inspireFly-VT/inspireFly-FlightController/inspireFly-flightController/bom/FlightController_BOM.xlsx

Sheet: Config
inspireFly Flight Controller BOM
Inputs
Boards to Build | 3 | Number of Flight Controller boards being manufactured
Spare / Attrition % | 10.0% | Extra % added to passives (C_/R_) before rounding up. Leave 0% for net quantity + rounding only.
Passive Round-Up Multiple | 5 | Footprints starting with C_ or R_ round up to the next multiple of this. Other parts are not rounded.
Summary
Unique Line Items | 32
Parts per Board | 76
Total Net Parts | 271
Lines with Part Number | 25
Lines Missing Part Number | 7
Lines with Distributor Part Number | 25
Lines Missing Distributor Part Number | 7
Lines Missing from Order Sheets | 0
Legend
Blue text | Hardcoded input / manual entry
Yellow fill | Cells you should fill in (board count, sourcing for parts not yet found)
Black text | Formula - do not overwrite
Green text | Formula linking to another sheet
Qty per Board is counted from the References column, so adding/removing a designator updates every total. Digikey sheet column A pulls the Distributor Part Number from the BOM. Source data: inspireFly-flightController.csv (KiCad BOM export); sourcing for matching parts carried over from RemotePCB_BOM.xlsx.

Sheet: BOM
Item | References | Value | Footprint | Qty per Board | Total Qty | Distributor | Part Number | Distributor Part Number | Part Description | Order Sheet Check
1 | C3, C4, C5, C6, C8, C9, C10, C12, C15, C16, C22, C26, C32, C33, C35 | 100nF | C_0402_1005Metric_Pad0.74x0.62mm_HandSolder | 15 | 50 | Digikey | GRM155R71H104KE14D | 490-10700-1-ND | CAP CER 0.1UF 50V X7R 0402 | Found
2 | C7, C11, C23, C24, C25, C27, C28 | 1uF | C_0402_1005Metric_Pad0.74x0.62mm_HandSolder | 7 | 25 | Digikey | KAM05CR71A105KH | 478-KAM05CR71A105KHCT-ND | 0402 X7R 1UF10% 10V AEC-Q200 | Found
3 | C13, C14 | 22pF | C_0402_1005Metric_Pad0.74x0.62mm_HandSolder | 2 | 10 | Digikey | CC0402JRNPO9BN220 | 311-1018-1-ND | CAP CER 22PF 50V C0G/NPO 0402 | Found
4 | C17, C18 | 18pF | C_0402_1005Metric_Pad0.74x0.62mm_HandSolder | 2 | 10 | Digikey | CC0402JRNPO9BN180 | 311-1415-1-ND | CAP CER 18PF 50V C0G/NPO 0402 | Found
5 | C19, C29 | 10nF | C_0402_1005Metric_Pad0.74x0.62mm_HandSolder | 2 | 10 | Digikey | CC0402KRX7R9BB103 | 311-1349-1-ND | CAP CER 10000PF 50V X7R 0402 | Found
6 | C20, C30 | 1.5F | SUPERCAP_KR-5R5H155-R | 2 | 6 | Digikey | KR-5R5H155-R | 283-KR-5R5H155-R-ND | CAP 1.5F -20% +80% 5.5V T/H | Found
7 | C1 | 4.7uF | C_0603_1608Metric | 1 | 5 | Digikey | GMC10X7R475K10NT | 4713-GMC10X7R475K10NTCT-ND | CAP0603 X7R 4.7UF 10% 10V | Found
8 | C2 | 10uF | C_0603_1608Metric | 1 | 5 | Digikey | GMC10X7R106K10NT | 4713-GMC10X7R106K10NTCT-ND | CAP0603 X7R 10UF 10% 10V | Found
9 | C31 | 2.2nF | C_0402_1005Metric_Pad0.74x0.62mm_HandSolder | 1 | 5 | Digikey | CC0402KRX7R9BB222 | 311-1037-1-ND | CAP CER 2200PF 50V X7R 0402 | Found
10 | C34 | 22nF | C_0402_1005Metric_Pad0.74x0.62mm_HandSolder | 1 | 5 | Digikey | CC0402KRX7R9BB223 | 311-1722-1-ND | CAP CER 0.022UF 50V X7R 0402 | Found
11 | R1, R3, R4, R5, R10, R13, R14, R15, R18, R20, R37, R38, R40 | 10K | R_0402_1005Metric_Pad0.72x0.64mm_HandSolder | 13 | 45 | Digikey | ERA-2AEB103X | P10KDCCT-ND | RES SMD 10K OHM 0.1% 1/16W 0402 | Found
12 | R6, R16, R17, R19, R39 | 4.7k | R_0402_1005Metric_Pad0.72x0.64mm_HandSolder | 5 | 20 | Digikey | RT0402BRD074K7L | YAG1446CT-ND | RES SMD 4.7K OHM 0.1% 1/16W 0402 | Found
13 | R8, R11, R12 | 100k | R_0402_1005Metric_Pad0.72x0.64mm_HandSolder | 3 | 10 | Digikey | RT0402BRE07100KL | YAG2304CT-ND | RES SMD 100K OHM 0.1% 1/16W 0402 | Found
14 | R9 | 150k | R_0402_1005Metric_Pad0.72x0.64mm_HandSolder | 1 | 5 | Digikey | RT0402BRD07150KL | 13-RT0402BRD07150KLCT-ND | RES 150K OHM 0.1% 1/16W 0402 | Found
15 | U3, U6 | RV-8803-C7 | RTC_RV-8803-C7 | 2 | 6 | Digikey | RV-8803-C7-32.768KHZ-3PPM-TA-QA | 2195-RV-8803-C7-32.768KHZ-3PPM-TA-QACT-ND | IC RTC CLK/CALENDAR I2C 8SON | Found
16 | U1 | STM32U595VJT6 | LQFP-100_14x14mm_P0.5mm | 1 | 3 | STM | STM32U595VIT6 | STM32U595VIT6 | Ultra-low-power with FPU Arm Cortex-M33 MCU with TrustZone, 160 MHz with 2 Mbytes of Flash memory | Found
17 | U2 | BNO086 | BNO086 | 1 | 3 | Digikey | BNO086 | 1888-BNO086CT-ND | ACCELROMETER/GYRO SMD | Found
18 | U4 | LM66100DCK | SOT-363_SC-70-6 | 1 | 3 | Digikey | LM66100DCKR | 296-53541-1-ND | IC OR CTRLR IDEAL DIODE SC70-6 | Found
19 | U5 | TPS2117 | PWRMUX_TPS2117-DRL | 1 | 3 | Digikey | TPS2117DRLR | 296-TPS2117DRLRCT-ND | IC POWER SW SOT-583 | Found
20 | U7 | MX60LF8G28AD-TI | TSOPI48_MAC | 1 | 3 | Digikey | MX60LF8G28AD-TI | 1092-MX60LF8G28AD-TI-ND | IC FLASH 8GBIT PARALLEL 48TSOP | Found
21 | U8 | S-19400G28A-K8T2U4 | TMSOP-8 | 1 | 3 | Digikey | S-19400G28A-K8T2U4 | 1662-S-19400G28A-K8T2U4CT-ND | WATCHDOG TIMER | Found
22 | Y1 | ABS07-32.768KHZ-T | XTAL_ABS07-32.768KHZ-T | 1 | 3 | Digikey | ABS07-32.768KHZ-T | 535-9542-1-ND | CRYSTAL 32.7680KHZ 12.5PF SMD | Found
23 | Y2 | 32.768KHZ | XTAL_ABS07-32.768KHZ-T | 1 | 3 | Digikey | ABS07-32.768KHZ-T | 535-9542-1-ND | CRYSTAL 32.7680KHZ 12.5PF SMD | Found
24 | SW1, SW3 | SW_Push | SW_TL1015AF160QG | 2 | 6 | Digikey | TL1015AF160QG | EG4344CT-ND | SWITCH TACTILE SPST-NO 0.05A 12V | Found
25 | TP1 | VACP_A1 | TestPoint_Pad_D1.5mm | 1 | 3 |  |  |  |  | No Part #
26 | TP3 | VRTC_A | TestPoint_Pad_D1.5mm | 1 | 3 |  |  |  |  | No Part #
27 | TP4 | RTC_A_ST | TestPoint_Pad_D1.5mm | 1 | 3 |  |  |  |  | No Part #
28 | TP5 | RTC_B_ST | TestPoint_Pad_D1.5mm | 1 | 3 |  |  |  |  | No Part #
29 | TP6 | VRTC_B | TestPoint_Pad_D1.5mm | 1 | 3 |  |  |  |  | No Part #
30 | TP7 | VCAP_B1 | TestPoint_Pad_D1.5mm | 1 | 3 |  |  |  |  | No Part #
31 | J1 | FTSH-107-01-L-DV-K-A | SAMTEC_FTSH-107-01-L-DV-K-A | 1 | 3 | Digikey | FTSH-107-01-L-DV-K-A | FTSH-107-01-L-DV-K-A-ND | CONN HEADER SMD 14POS 1.27MM | Found
32 | J2 | Conn_01x05 | PinSocket_1x05_P2.54mm_Vertical | 1 | 3 |  |  |  |  | No Part #
 |  |  | TOTAL | 76 | 271

Sheet: Digikey
Digi-Key Part Number | Manufacturer Part Number | Quantity | Customer Reference
490-10700-1-ND | GRM155R71H104KE14D | 50 | 100nF
478-KAM05CR71A105KHCT-ND | KAM05CR71A105KH | 25 | 1uF
311-1018-1-ND | CC0402JRNPO9BN220 | 10 | 22pF
311-1415-1-ND | CC0402JRNPO9BN180 | 10 | 18pF
311-1349-1-ND | CC0402KRX7R9BB103 | 10 | 10nF
283-KR-5R5H155-R-ND | KR-5R5H155-R | 6 | 1.5F
4713-GMC10X7R475K10NTCT-ND | GMC10X7R475K10NT | 5 | 4.7uF
4713-GMC10X7R106K10NTCT-ND | GMC10X7R106K10NT | 5 | 10uF
311-1037-1-ND | CC0402KRX7R9BB222 | 5 | 2.2nF
311-1722-1-ND | CC0402KRX7R9BB223 | 5 | 22nF
P10KDCCT-ND | ERA-2AEB103X | 45 | 10K
YAG1446CT-ND | RT0402BRD074K7L | 20 | 4.7k
YAG2304CT-ND | RT0402BRE07100KL | 10 | 100k
13-RT0402BRD07150KLCT-ND | RT0402BRD07150KL | 5 | 150k
2195-RV-8803-C7-32.768KHZ-3PPM-TA-QACT-ND | RV-8803-C7-32.768KHZ-3PPM-TA-QA | 6 | RV-8803-C7
1888-BNO086CT-ND | BNO086 | 3 | BNO086
296-53541-1-ND | LM66100DCKR | 3 | LM66100DCK
296-TPS2117DRLRCT-ND | TPS2117DRLR | 3 | TPS2117
1092-MX60LF8G28AD-TI-ND | MX60LF8G28AD-TI | 3 | MX60LF8G28AD-TI
1662-S-19400G28A-K8T2U4CT-ND | S-19400G28A-K8T2U4 | 3 | S-19400G28A-K8T2U4
535-9542-1-ND | ABS07-32.768KHZ-T | 6 | ABS07-32.768KHZ-T
EG4344CT-ND | TL1015AF160QG | 6 | SW_Push
FTSH-107-01-L-DV-K-A-ND | FTSH-107-01-L-DV-K-A | 3 | FTSH-107-01-L-DV-K-A

Sheet: Other Distributors
Distributor | Part Number | Quantity | Customer Reference | Distributor Part Number
STM | STM32U595VIT6 | 3 | STM32U595VJT6 | STM32U595VIT6
