inspireFly-VT/inspireFly-FlightController/inspireFly-flightController/bom/RemotePCB_BOM.xlsx

Sheet: Config
RemotePCB BOM
Inputs
Boards to Build | 3 | Number of RemotePCB boards being manufactured
Spare / Attrition % | 10.0% | Extra % added to passives (C_/R_) before rounding up. Leave 0% for net quantity + rounding only.
Passive Round-Up Multiple | 5 | Footprints starting with C_ or R_ round up to the next multiple of this. Other parts are not rounded.
Summary
Unique Line Items
Parts per Board
Total Net Parts
Lines with Part Number
Lines Missing Part Number
Lines Priced
Total BOM Cost
Cost per Board
Lines Missing from Order Sheets
Legend
Blue text | Hardcoded input / manual entry
Yellow fill | Cells you should fill in (board count, unit prices)
Black text | Formula - do not overwrite
Green text | Formula linking to another sheet
Qty per Board is counted from the References column, so adding/removing a designator updates every total. Source data: RemotePCB (1).csv (KiCad BOM export, 2026-10-26).

Sheet: BOM
Item | References | Value | Footprint | Qty per Board | Total Qty | Distributor | Part Number | Part Description | Unit Price | Extended Price | Notes | Order Sheet Check
1 | C2, C3, C5, C8, C13, C14, C18, C19, C21, C23, C24, C25, C27, C28, C29, C31, C42, C43 | 100nF | C_0402_1005Metric_Pad0.74x0.62mm_HandSolder |  |  | Digikey | GRM155R71H104KE14D | CAP CER 0.1UF 50V X7R 0402 | $0.0170 |  | Passive Component
2 | C15, C17, C34, C36, C39, C40, C41, C45, C46 | 10uF | C_0805_2012Metric |  |  | Digikey | GMC21X7R106K16NT | CAP0805 X7R 10UF 10% 16V | $0.3830 |  | Passive Component
3 | C1, C30, C32, C33, C35 | 1uF | C_0402_1005Metric_Pad0.74x0.62mm_HandSolder |  |  | Digikey | KAM05CR71A105KH | 0402 X7R 1UF10% 10V AEC-Q200 | $0.1210 |  | Passive Component
4 | C9, C10, C11, C12 | 18pF | C_0402_1005Metric_Pad0.74x0.62mm_HandSolder |  |  | Digikey | CC0402JRNPO9BN180 | CAP CER 18PF 50V C0G/NPO 0402 | $0.0340 |  | Passive Component
5 | C4, C44 | 470nF | C_0402_1005Metric_Pad0.74x0.62mm_HandSolder |  |  | Digikey | GRT155R71A474KE01D | CAP CER 0.47UF 10V X7R 0402 | $0.2220 |  | Passive Component
6 | C6, C37 | 47nF | C_0402_1005Metric_Pad0.74x0.62mm_HandSolder |  |  | Digikey | GRM155R71H473KE14D | CAP CER 0.047UF 50V X7R 0402 | $0.0230 |  | Passive Component
7 | C22, C26 | 2.2uF | C_0603_1608Metric |  |  | Digikey | GRM188R71A225KE15J | CAP CER 2.2UF 10V X7R 0603 | $0.0870 |  | Passive Component
8 | C7 | 47pF | C_0402_1005Metric_Pad0.74x0.62mm_HandSolder |  |  | Digikey | CC0402JRNPO9BN470 | CAP CER 47PF 50V C0G/NPO 0402 | $0.1000 |  | Passive Component
9 | C38 | 4.7uF | C_0603_1608Metric |  |  | Digikey | GMC10X7R475K10NT | CAP0603 X7R 4.7UF 10% 10V | $0.4700 |  | Passive Component
10 | R1, R2, R3, R9, R14, R16, R17, R21, R25, R26 | 10k | R_0402_1005Metric_Pad0.72x0.64mm_HandSolder |  |  | Digikey | ERA-2AEB103X | RES SMD 10K OHM 0.1% 1/16W 0402 | $0.0930 |  | Passive Component
11 | R4, R10 | 100k | R_0402_1005Metric_Pad0.72x0.64mm_HandSolder |  |  | Digikey | RT0402BRE07100KL | RES SMD 100K OHM 0.1% 1/16W 0402 | $0.1100 |  | Passive Component
12 | R11, R12 | 2.2k | R_0402_1005Metric_Pad0.72x0.64mm_HandSolder |  |  | Digikey | ERA-2VEB2201X | RES 2.2K OHM 0.1% 1/10W 0402 | $0.2400 |  | Passive Component
13 | R18, R19 | 5.1k | R_0402_1005Metric_Pad0.72x0.64mm_HandSolder |  |  | Digikey | RC0402FR-075K1L | RES 5.1K OHM 1% 1/16W 0402 | $0.0210 |  | Passive Component
14 | R13 | 261 | R_0402_1005Metric_Pad0.72x0.64mm_HandSolder |  |  | Digikey | ERJ-2RKF2610X | RES SMD 261 OHM 1% 1/10W 0402 | $0.1000 |  | Passive Component
15 | R15 | 15k | R_0402_1005Metric_Pad0.72x0.64mm_HandSolder |  |  | Digikey | RC0402FR-0715KL | RES 15K OHM 1% 1/16W 0402 | $0.1000 |  | Passive Component
16 | R20 | 5m | R_1206_3216Metric |  |  | Digikey | CSRF1206FT5L00 | RES 0.005 OHM 1% 1W 1206 | $0.6000 |  | Passive Component
17 | R22 | 280k | R_0402_1005Metric_Pad0.72x0.64mm_HandSolder |  |  | Digikey | CPF0402B280KE1 | CPF 0402 280K 0.1% 25PPM 1K RL | $0.3100 |  | Passive Component
18 | R23 | 50k | R_0402_1005Metric_Pad0.72x0.64mm_HandSolder |  |  | Digikey | RNCF0402DKE50K0 | RES SMD 50K OHM 0.5% 1/10W 0402 | $0.1000 |  | Passive Component
19 | L1 | 15uH | L_0603_1608Metric |  |  | Digikey | MLZ1608N150LT000 | FIXED IND 15UH 250MA 1.02 OHM | $0.1000 |  | Passive Component
20 | L2 | 47nH | L_0402_1005Metric |  |  | Digikey | LQW15AN47NJ00D | FIXED IND 47NH 210MA 1.08 OHM | $0.1100 |  | Passive Component
21 | L3 | 2.2uH | L_0805_2012Metric_Pad1.05x1.20mm_HandSolder |  |  | Digikey | ASMPH-0806-2R2M-T | FIXED IND 2.2UH 1.2A 110 MOHM | $0.2400 |  | Passive Component
22 | L4 | 1.0 uH | IND_IHLP-2020CZ-8A_VIS |  |  | Digikey | IHLP2020CZER1R0M8A | FIXED IND 1UH 10.8A 12.1 MOHM | $1.2000 |  | Passive Component
23 | L5 | 470nH | L_0805_2012Metric |  |  | Digikey | AOTA-B201210SR47MT | IND 0.47UH 4.8A 24MOHM | $0.2600 |  | Passive Component
24 | D1, D2 | LTST-C190GKT | LED_0603_1608Metric_Pad1.05x0.95mm_HandSolder |  |  | Digikey | LTST-C190GKT | LED GREEN CLEAR CHIP SMD | $0.1400 |  | Power Systems
25 | U1 | STM32U375RGT6Q | LQFP64_STM |  |  | Digikey | STM32U375RGT6Q | ULTRA-LOW-POWER WITH FPU ARM COR | $7.1900 |  | Embedded Controls
26 | U2 | SX1262IMLTRT | QFN50P400X400X100-25N |  |  | Digikey | SX1262IMLTRT | IC RF TXRX ISM<1GHZ 24QFN | $9.0400 |  | Communication Systems
27 | U3 | BNO086 | BNO086 |  |  | Digikey | BNO086 | ACCELROMETER/GYRO SMD | $15.7900 |  | Embedded Controls
28 | U4 | 0900FM15K0039001E | QFP20P0X0X31-0_JOT |  |  | Digikey | 0900FM15K0039001E | CER FILTER 895MHZ BAND PASS | $0.4900 |  | Communication Systems
29 | U6 | BGM220PC22WGA2R | BGM220P_SIL |  |  | Digikey | BGM220PC22WGA2R | RF TXRX MOD BLUETOOTH CHIP SMD | $8.6500 |  | Communication Systems
30 | U7 | LP5018RSMR | QFN40P400X400X100-33N |  |  | Digikey | LP5018RSMR | IC LED DRVR LIN I2C 35MA 32VQFN | $1.5000 |  | Embedded Controls
31 | U8 | BQ25896RTWR | RTW0024H |  |  | Digikey | BQ25896RTWR | IC BATT CHG LI-ION 1CELL 24WQFN | $3.3900 |  | Power Systems
32 | U9 | MAX17055ETB+T | 21-100013A_T102A2&plus_1C_MXM |  |  | Digikey | MAX17055ETB+T | IC BATT MON MULTI-CHEM 1C 10TDFN | $4.6600 |  | Power Systems
33 | U10 | USBLC6-2P6 | SOT50P160X60-6N |  |  | Digikey | USBLC6-2P6 | TVS DIODE 5.25VWM 17VC SOT666 | $0.6500 |  | Embedded Controls
34 | U11 | TPS63802DLAR | VREG_TPS63802DLAR |  |  | Digikey | TPS63802DLAR | IC REG BUCK BOOST ADJ 2A 10VSON | $3.0000 |  | Power Systems
35 | Y2, Y3 | 32.768kHz | XTAL_ABS07-32.768KHZ-T |  |  | Digikey | ABS07-32.768KHZ-T | CRYSTAL 32.7680KHZ 12.5PF SMD | $0.6100 |  | Embedded Controls
36 | Y1 | ABM11N-32.0000MHZ-10-B1U-T3 | Crystal_SMD_2016-4Pin_2.0x1.6mm |  |  | Digikey | ABM11N-32.0000MHZ-10-B1U-T3 | CRYSTAL 32.0000MHZ 10PF SMD | $0.6400 |  | Communication Systems
37 | SW1, SW2, SW4 | SW_TL1015AF160QG | SW_TL1015AF160QG |  | 10 | Digikey | TL1015AF160QG | SWITCH TACTILE SPST-NO 0.05A 12V | $0.4170 |  | Embedded Controls
38 | LED1, LED2, LED3 | IN-S66TFT5R5G5B | INS66TFT5R5G5B |  | 10 | Digikey | IN-S66TFT5R5G5B | LED RGB CLEAR 0606 SMD | $0.2710 |  | Embedded Controls
39 | IC1 | DWM3000TR13 | DWM3000TR13 |  |  | Digikey | DWM3000TR13 | DWM3000 UWB XCVR MODULE | $23.6200 |  | Communication Systems
40 | RN1 | EXB-38V472JV | RESCAXS80P320X160X60-8N |  |  | Digikey | EXB-38V472JV | RES ARRAY 4 RES 4.7K OHM 1206 | $0.1000 |  | Passive Component
41 | S1 | BGS12WN6E6327XTSA1 | BGS12WN6E6327XTSA1 |  |  | Digikey | BGS12WN6E6327XTSA1 | IC RF SWITCH SPDT 9GHZ TSNP6-10 | $0.3200 |  | Communication Systems
42 | J1 | Conn_Coaxial | CONN_RSP-122811-01_SAI |  |  | Digikey | RSP-122811-01 | CONN UMC RCPT STR 50 OHM SMD | $0.9600 |  | Connector
43 | J2 | UJ20-C-H-G-SMT-1-P16-TR | SAMESKY_UJ20-C-H-G-SMT-1-P16-TR |  |  | Digikey | UJ20-C-H-G-SMT-1-P16-TR | CONN RCPT USB 2.0 TYPE C SMD RA | $0.4900 |  | Connector
44 | J3 | Conn_01x02_Pin | CONN_S2B-PH-K-S_JST |  |  | Digikey | S2B-PH-K-S | CONN HEADER R/A 2POS 2MM | $0.1200 |  | Connector
45 | J4 | Conn_01x04_Pin | PinSocket_1x04_P2.54mm_Vertical |  |  | Digikey | 61300411821 | WR-PHD 2.54 MM SOCKET HEADER 4 P | $0.4200 |  | Connector
46 | J5 | Conn_01x05_Pin | PinSocket_1x05_P2.54mm_Vertical |  |  | Digikey | 61300511821 | WR-PHD 2.54 MM SOCKET HEADER 5 P | $0.3300 |  | Connector
 |  |  | TOTAL

Sheet: Digikey
Digi-Key Part Number | Manufacturer Part Number | Quantity | Customer Reference | Packaging
490-10700-1-ND | GRM155R71H104KE14D |  |  | Cut Tape
4713-GMC21X7R106K16NTCT-ND | GMC21X7R106K16NT |  |  | Cut Tape
478-KAM05CR71A105KHCT-ND | KAM05CR71A105KH |  |  | Cut Tape
311-1415-1-ND | CC0402JRNPO9BN180 |  |  | Cut Tape
490-GRT155R71A474KE01DCT-ND | GRT155R71A474KE01D |  |  | Cut Tape
490-10702-1-ND | GRM155R71H473KE14D |  |  | Cut Tape
490-6418-1-ND | GRM188R71A225KE15J |  |  | Cut Tape
311-1021-1-ND | CC0402JRNPO9BN470 |  |  | Cut Tape
4713-GMC10X7R475K10NTCT-ND | GMC10X7R475K10NT |  |  | Cut Tape
P10KDCCT-ND | ERA-2AEB103X |  |  | Cut Tape
YAG2304CT-ND | RT0402BRE07100KL |  |  | Cut Tape
10-ERA-2VEB2201XCT-ND | ERA-2VEB2201X |  |  | Cut Tape
311-5.10KLRCT-ND | RC0402FR-075K1L |  |  | Cut Tape
P261LCT-ND | ERJ-2RKF2610X |  |  | Cut Tape
311-15.0KLRCT-ND | RC0402FR-0715KL |  |  | Cut Tape
CSRF1206FT5L00CT-ND | CSRF1206FT5L00 |  |  | Cut Tape
1712-CPF0402B280KE1CT-ND | CPF0402B280KE1 |  |  | Cut Tape
738-RNCF0402DKE50K0CT-ND | RNCF0402DKE50K0 |  |  | Cut Tape
445-MLZ1608N150LT000CT-ND | MLZ1608N150LT000 |  |  | Cut Tape
490-1154-1-ND | LQW15AN47NJ00D |  |  | Cut Tape
535-12278-1-ND | ASMPH-0806-2R2M-T |  |  | Cut Tape
541-IHLP2020CZER1R0M8ACT-ND | IHLP2020CZER1R0M8A |  |  | Cut Tape
535-AOTA-B201210SR47MTCT-ND | AOTA-B201210SR47MT |  |  | Cut Tape
160-LTST-C190GKTCT-ND | LTST-C190GKT |  |  | Cut Tape
497-STM32U375RGT6Q-ND | STM32U375RGT6Q |  |  | Tray
SX1262IMLTRTCT-ND | SX1262IMLTRT |  |  | Cut Tape
1888-BNO086CT-ND | BNO086 |  |  | Cut Tape
712-0900FM15K0039001ECT-ND | 0900FM15K0039001E |  |  | Cut Tape
336-BGM220PC22WGA2RCT-ND | BGM220PC22WGA2R |  |  | Cut Tape
296-50813-1-ND | LP5018RSMR |  |  | Cut Tape
296-46289-1-ND | BQ25896RTWR |  |  | Cut Tape
MAX17055ETB+TCT-ND | MAX17055ETB+T |  |  | Cut Tape
497-5026-1-ND | USBLC6-2P6 |  |  | Cut Tape
296-TPS63802DLARCT-ND | TPS63802DLAR |  |  | Cut Tape
535-9542-1-ND | ABS07-32.768KHZ-T |  |  | Cut Tape
535-ABM11N-32.0000MHZ-10-B1U-T3CT-ND | ABM11N-32.0000MHZ-10-B1U-T3 |  |  | Cut Tape
EG4344CT-ND | TL1015AF160QG |  |  | Cut Tape
1830-IN-S66TFT5R5G5BCT-ND | IN-S66TFT5R5G5B |  |  | Cut Tape
2312-DWM3000TR13CT-ND | DWM3000TR13 |  |  | Cut Tape
Y9472CT-ND | EXB-38V472JV |  |  | Cut Tape
448-BGS12WN6E6327XTSA1CT-ND | BGS12WN6E6327XTSA1 |  |  | Cut Tape
612-RSP-122811-01CT-ND | RSP-122811-01 |  |  | Cut Tape
2223-UJ20-C-H-G-SMT-1-P16-TRCT-ND | UJ20-C-H-G-SMT-1-P16-TR |  |  | Cut Tape
455-1719-ND | S2B-PH-K-S |  |  | Bulk
732-61300411821-ND | 61300411821 |  |  | Tray
732-61300511821-ND | 61300511821 |  |  | Tray

Sheet: Other Distributors
Distributor | Part Number | Quantity | Customer Reference | Notes
