inspireFly-VT/inspireFly-FlightController/inspireFly-flightController/production/bom.csv

Designator | Footprint | Quantity | Value | LCSC Part #
C1 | 0603 | 1 | 4.7uF
C10, C12, C15, C16, C22, C26, C3, C32, C33, C35, C4, C5, C6, C8, C9 | 0402 | 15 | 100nF
C11, C23, C24, C25, C27, C28, C7 | 0402 | 7 | 1uF
C13, C14 | 0402 | 2 | 22pF
C17, C18 | 0402 | 2 | 18pF
C19, C29 | 0402 | 2 | 10nF
C2 | 0603 | 1 | 10uF
C20, C30 | SUPERCAP_KR-5R5H155-R | 2 | 1.5F
C31 | 0402 | 1 | 2.2nF
C34 | 0402 | 1 | 22nF
J1 | SAMTEC_FTSH-107-01-L-DV-K-A | 1 | FTSH-107-01-L-DV-K-A
J2 | PinSocket_1x05_P2.54mm_Vertical | 1 | Conn_01x05
R1, R10, R13, R14, R15, R18, R20, R3, R37, R38, R4, R40, R5 | 0402 | 13 | 10k
R11, R12, R8 | 0402 | 3 | 100k
R16, R17, R19, R39, R6 | 0402 | 5 | 4.7k
R9 | 0402 | 1 | 150k
SW1, SW3 | SW_TL1015AF160QG | 2 | SW_Push
TP1 | TestPoint_Pad_D1.5mm | 1 | VACP_A1
TP3 | TestPoint_Pad_D1.5mm | 1 | VRTC_A
TP4 | TestPoint_Pad_D1.5mm | 1 | RTC_A_ST
TP5 | TestPoint_Pad_D1.5mm | 1 | RTC_B_ST
TP6 | TestPoint_Pad_D1.5mm | 1 | VRTC_B
TP7 | TestPoint_Pad_D1.5mm | 1 | VCAP_B1
U1 | LQFP-100_14x14mm_P0.5mm | 1 | STM32U595VJT6
U2 | BNO086 | 1 | BNO086
U3, U6 | RTC_RV-8803-C7 | 2 | RV-8803-C7
U4 | SOT-363_SC-70-6 | 1 | LM66100DCK
U5 | PWRMUX_TPS2117-DRL | 1 | TPS2117
U7 | TSOPI48_MAC | 1 | MX60LF8G28AD-TI
U8 | TMSOP-8 | 1 | S-19400G28A-K8T2U4 | S-19400G28A-K8T2U4
Y1 | XTAL_ABS07-32.768KHZ-T | 1 | ABS07-32.768KHZ-T
Y2 | XTAL_ABS07-32.768KHZ-T | 1 | 32.768KHZ
