inspireFly-VT/inspireFly-FlightController/inspireFly-flightController/inspireFly-flightController.kicad_pcb

## KiCad design inspireFly-flightController/inspireFly-flightController.kicad_pcb (2026-11-12)

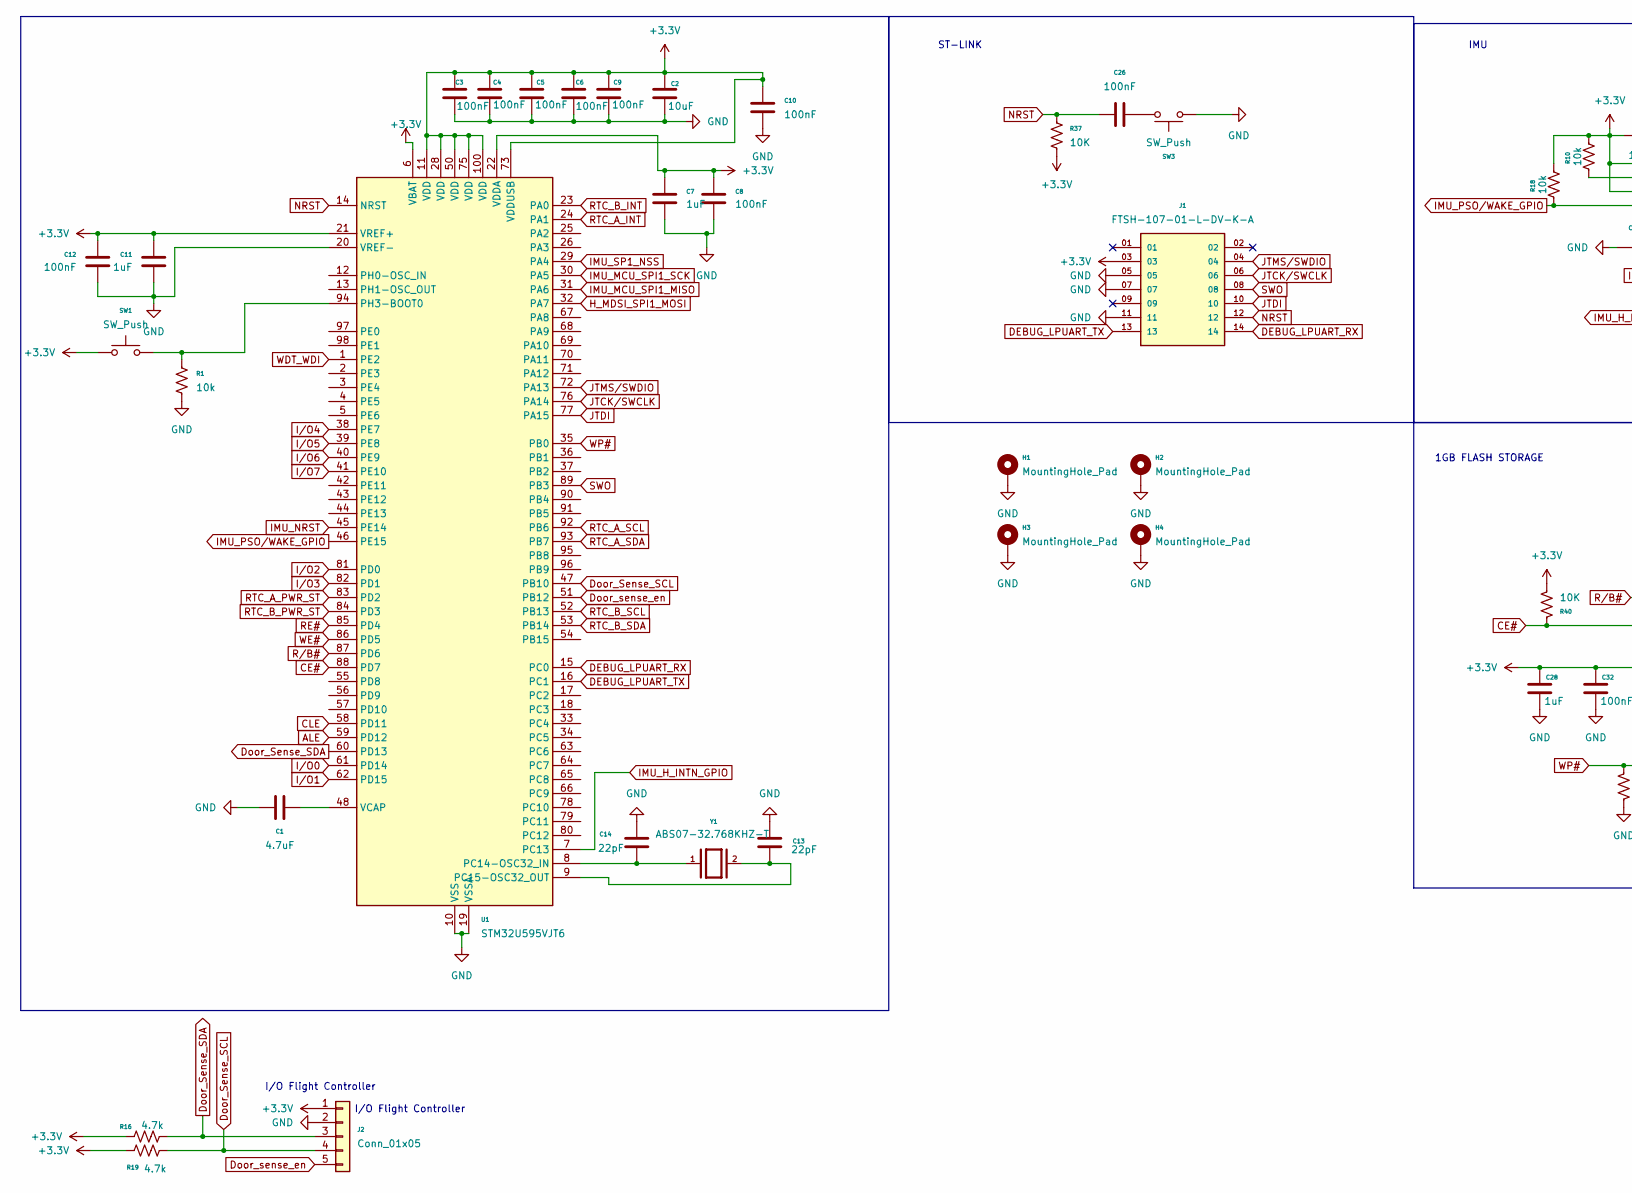
[picture p1: schematic inspireFly-flightController.kicad_sch, part in row 1, column 1]

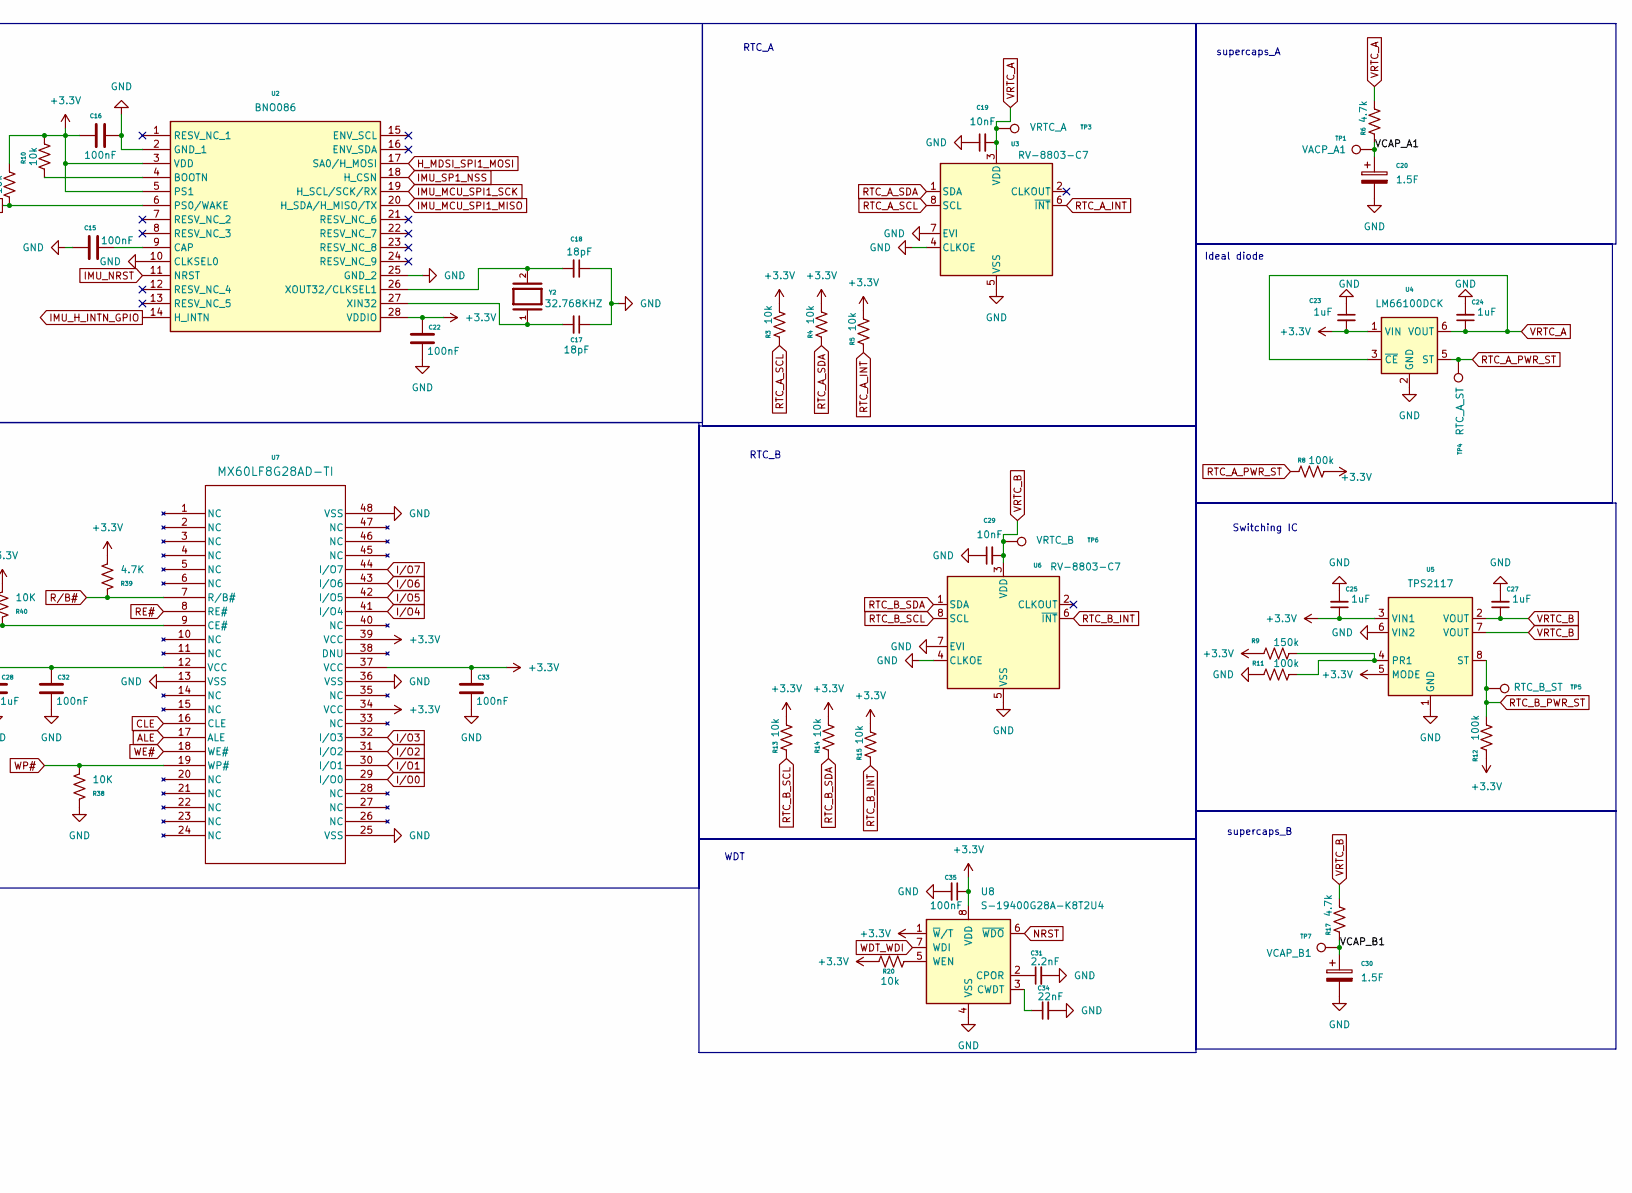
[picture p2: schematic inspireFly-flightController.kicad_sch, part in row 1, column 2]

Parts:
C1: 4.7uF; C_0603_1608Metric
C2: 10uF; C_0603_1608Metric
C3, C4, C5, C6, C8, C9, C10, C12, C15, C16, C22, C26, C32, C33, C35: 100nF; C_0402_1005Metric_Pad0.74x0.62mm_HandSolder
C7, C11, C23, C24, C25, C27, C28: 1uF; C_0402_1005Metric_Pad0.74x0.62mm_HandSolder
C13, C14: 22pF; C_0402_1005Metric_Pad0.74x0.62mm_HandSolder
C17, C18: 18pF; C_0402_1005Metric_Pad0.74x0.62mm_HandSolder
C19, C29: 10nF; C_0402_1005Metric_Pad0.74x0.62mm_HandSolder
C20, C30: 1.5F; SUPERCAP_KR-5R5H155-R
C31: 2.2nF; C_0402_1005Metric_Pad0.74x0.62mm_HandSolder
C34: 22nF; C_0402_1005Metric_Pad0.74x0.62mm_HandSolder
H1, H2, H3, H4: MountingHole_Pad; MountingHole_2.2mm_M2_Pad_TopBottom
J1: FTSH-107-01-L-DV-K-A; SAMTEC_FTSH-107-01-L-DV-K-A; PARTREV H
J2: Conn_01x05; PinSocket_1x05_P2.54mm_Vertical
R1, R3, R4, R5, R10, R13, R14, R15, R18, R20: 10k; R_0402_1005Metric_Pad0.72x0.64mm_HandSolder
R6, R16, R17, R19: 4.7k; R_0402_1005Metric_Pad0.72x0.64mm_HandSolder
R8, R11, R12: 100k; R_0402_1005Metric_Pad0.72x0.64mm_HandSolder
R9: 150k; R_0402_1005Metric_Pad0.72x0.64mm_HandSolder
R37, R38, R40: 10K; R_0402_1005Metric_Pad0.72x0.64mm_HandSolder
R39: 4.7K; R_0402_1005Metric_Pad0.72x0.64mm_HandSolder
SW1, SW3: SW_Push; SW_TL1015AF160QG
TP1: VACP_A1; TestPoint_Pad_D1.5mm
TP3: VRTC_A; TestPoint_Pad_D1.5mm
TP4: RTC_A_ST; TestPoint_Pad_D1.5mm
TP5: RTC_B_ST; TestPoint_Pad_D1.5mm
TP6: VRTC_B; TestPoint_Pad_D1.5mm
TP7: VCAP_B1; TestPoint_Pad_D1.5mm
U1: STM32U595VJT6; LQFP-100_14x14mm_P0.5mm
U2: BNO086; Mouser Part Number 526-BNO086
U3, U6: RV-8803-C7; RTC_RV-8803-C7
U4: LM66100DCK; SOT-363_SC-70-6
U5: TPS2117; PWRMUX_TPS2117-DRL
U7: MX60LF8G28AD-TI; TSOPI48_MAC
U8: S-19400G28A-K8T2U4; TMSOP-8; MPN S-19400G28A-K8T2U4
Y1: ABS07-32.768KHZ-T; XTAL_ABS07-32.768KHZ-T; PARTREV 08.19.15
Y2: 32.768KHZ; XTAL_ABS07-32.768KHZ-T; PARTREV 08.19.15

Connections:
+3.3V: C2.1, C3.1, C4.1, C5.1, C6.1, C7.1, C8.1, C9.1, C10.1, C11.1, C12.1, C16.2, C22.1, C23.2, C25.1, C28.1, C32.1, C33.1, C35.1, J1.03, J2.1, R3.2, R4.2, R5.2, R8.2, R9.1, R10.1, R12.1, R13.2, R14.2, R15.2, R16.1, R18.1, R19.1, R20.1, R37.2, R39.2, R40.2, SW1.1, U1.6 (VBAT), U1.11 (VDD), U1.21 (VREF+), U1.22 (VDDA), U1.28 (VDD), U1.50 (VDD), U1.73 (VDDUSB), U1.75 (VDD), U1.100 (VDD), U2.3 (VDD), U2.5 (PS1), U2.28 (VDDIO), U4.1 (VIN), U5.3 (VIN1), U5.5 (MODE), U7.12 (VCC), U7.34 (VCC), U7.37 (VCC), U7.39 (VCC), U8.1 (~W/T), U8.8 (VDD)
/VCAP_A1: C20.1, R6.1, TP1.1 (1_1)
/VCAP_B1: C30.1, R17.1, TP7.1 (1_1)
ALE: U1.59 (PD12), U7.17 (ALE)
CE#: R40.1, U1.88 (PD7), U7.9 (CE#)
CLE: U1.58 (PD11), U7.16 (CLE)
DEBUG_LPUART_RX: J1.14, U1.15 (PC0)
DEBUG_LPUART_TX: J1.13, U1.16 (PC1)
Door_Sense_SCL: J2.4, R19.2, U1.47 (PB10)
Door_Sense_SDA: J2.3, R16.2, U1.60 (PD13)
Door_sense_en: J2.5, U1.51 (PB12)
GND: C1.1, C2.2, C3.2, C4.2, C5.2, C6.2, C7.2, C8.2, C9.2, C10.2, C11.2, C12.2, C13.1, C14.1, C15.2, C16.1, C17.1, C18.1, C19.1, C20.2, C22.2, C23.1, C24.2, C25.2, C27.2, C28.2, C29.1, C30.2, C31.2, C32.2, C33.2, C34.2, C35.2, H1.1 (1_1), H2.1 (1_1), H3.1 (1_1), H4.1 (1_1), J1.05, J1.07, J1.11, J2.2, R1.2, R11.1, R38.1, SW3.1, U1.10 (VSS), U1.19 (VSSA), U1.20 (VREF-), U1.27 (VSS), U1.49 (VSS), U1.74 (VSS), U1.99 (VSS), U2.2 (GND_1), U2.10 (CLKSEL0), U2.25 (GND_2), U3.4 (CLKOE), U3.5 (VSS), U3.7 (EVI), U4.2 (GND), U5.1 (GND), U5.6 (VIN2), U6.4 (CLKOE), U6.5 (VSS), U6.7 (EVI), U7.13 (VSS), U7.25 (VSS), U7.36 (VSS), U7.48 (VSS), U8.4 (VSS)
H_MDSI_SPI1_MOSI: U1.32 (PA7), U2.17 (SA0/H_MOSI)
IMU_H_INTN_GPIO: U1.7 (PC13), U2.14 (H_INTN)
IMU_MCU_SPI1_MISO: U1.31 (PA6), U2.20 (H_SDA/H_MISO/TX)
IMU_MCU_SPI1_SCK: U1.30 (PA5), U2.19 (H_SCL/SCK/RX)
IMU_NRST: U1.45 (PE14), U2.11 (NRST)
IMU_PSO/WAKE_GPIO: R18.2, U1.46 (PE15), U2.6 (PS0/WAKE)
IMU_SP1_NSS: U1.29 (PA4), U2.18 (H_CSN)
I/O0: U1.61 (PD14), U7.29 (I/O0)
I/O1: U1.62 (PD15), U7.30 (I/O1)
I/O2: U1.81 (PD0), U7.31 (I/O2)
I/O3: U1.82 (PD1), U7.32 (I/O3)
I/O4: U1.38 (PE7), U7.41 (I/O4)
I/O5: U1.39 (PE8), U7.42 (I/O5)
I/O6: U1.40 (PE9), U7.43 (I/O6)
I/O7: U1.41 (PE10), U7.44 (I/O7)
JTCK/SWCLK: J1.06, U1.76 (PA14)
JTDI: J1.10, U1.77 (PA15)
JTMS/SWDIO: J1.04, U1.72 (PA13)
NRST: C26.2, J1.12, R37.1, U1.14 (NRST), U8.6 (~WDO)
unnamed: C26.1, SW3.2
unnamed: C14.2, U1.8 (PC14-OSC32_IN), Y1.1
unnamed: C13.2, U1.9 (PC15-OSC32_OUT), Y1.2
unnamed: R1.1, SW1.2, U1.94 (PH3-BOOT0)
unnamed: C1.2, U1.48 (VCAP)
unnamed: R10.2, U2.4 (BOOTN)
unnamed: C15.1, U2.9 (CAP)
unnamed: C17.2, U2.27 (XIN32), Y2.1
unnamed: C18.2, U2.26 (XOUT32/CLKSEL1), Y2.2
unnamed: R9.2, R11.2, U5.4 (PR1)
unnamed: C31.1, U8.2 (CPOR)
unnamed: C34.1, U8.3 (CWDT)
unnamed: R20.2, U8.5 (WEN)
RE#: U1.85 (PD4), U7.8 (RE#)
RTC_A_INT: R5.1, U1.24 (PA1), U3.6 (~INT)
RTC_A_PWR_ST: R8.1, TP4.1 (1_1), U1.83 (PD2), U4.5 (ST)
RTC_A_SCL: R3.1, U1.92 (PB6), U3.8 (SCL)
RTC_A_SDA: R4.1, U1.93 (PB7), U3.1 (SDA)
RTC_B_INT: R15.1, U1.23 (PA0), U6.6 (~INT)
RTC_B_PWR_ST: R12.2, TP5.1 (1_1), U1.84 (PD3), U5.8 (ST)
RTC_B_SCL: R13.1, U1.52 (PB13), U6.8 (SCL)
RTC_B_SDA: R14.1, U1.53 (PB14), U6.1 (SDA)
R/B#: R39.1, U1.87 (PD6), U7.7 (R/B#)
SWO: J1.08, U1.89 (PB3)
VRTC_A: C19.2, C24.1, R6.2, TP3.1 (1_1), U3.3 (VDD), U4.3 (~CE), U4.6 (VOUT)
VRTC_B: C27.1, C29.2, R17.2, TP6.1 (1_1), U5.2 (VOUT), U5.7 (VOUT), U6.3 (VDD)
WDT_WDI: U1.1 (PE2), U8.7 (WDI)
WE#: U1.86 (PD5), U7.18 (WE#)
WP#: R38.2, U1.35 (PB0), U7.19 (WP#)

Notes on the sheet:
ST-LINK
RTC_B
supercaps_A
Switching IC
I/O Flight Controller
supercaps_B
IMU
RTC_A
WDT
Ideal diode
1GB FLASH STORAGE

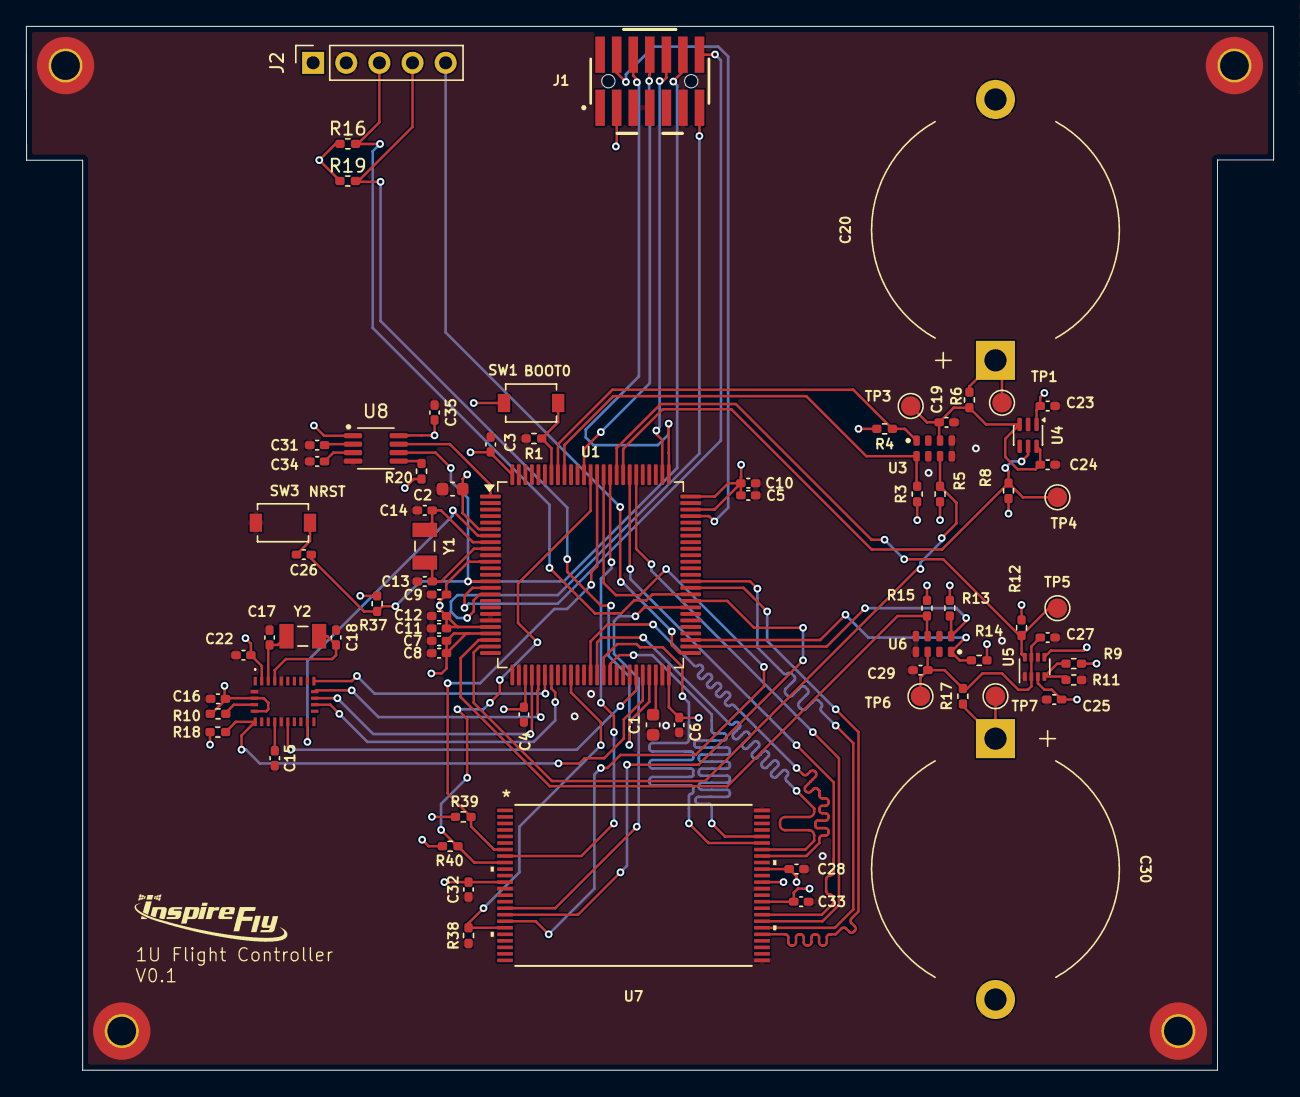
[picture p3: board inspireFly-flightController.kicad_pcb from above]

Board: 4 copper layers, 95.6 x 80.0 mm, 80 parts (0 on the bottom side), 60 nets.
