inspireFly-VT/inspireFly-FlightController/(commit log)

2025-11-08 added basic caps
    [inspireFly-flightController.kicad_pcb, inspireFly-flightController.kicad_sch]
2025-11-16 added all power caps
    [inspireFly-flightController.kicad_sch]
2025-11-19 Slight changes
    Removed cap on VBat
    Added 1uF and 100nF to VREF+
    Removed excess labels
    Cleaned up labels
    [inspireFly-flightController.kicad_sch]
2026-02-06 added Boot and crystal
    [inspireFly-flightController.kicad_sch]
2026-02-15 added 32kHz OSC
    [inspireFly-flightController.kicad_sch]
2026-02-21 added st-link connector
    [inspireFly-flightController.kicad_sch]
2026-03-01 Updated LPUART connections
    See teams message sent on 3/1
    [inspireFly-flightController.kicad_sch]
2026-03-08 added board edges
    [inspireFly-flightController.kicad_pcb, inspireFly-flightController.kicad_sch]
2026-03-08 updated osc cap orientation
    [inspireFly-flightController.kicad_sch]
2026-03-09 Board sizes + Layer stackup
    [inspireFly-flightController.kicad_pcb, inspireFly-flightController.kicad_sch]
2026-03-21 continued routing caps + updated footprints
    [inspireFly-flightController.kicad_pcb, inspireFly-flightController.kicad_sch]
2026-03-28 routed all power cap
    [inspireFly-flightController.kicad_pcb]
2026-03-31 rerouted power caps +stlink
    [inspireFly-flightController.kicad_pcb]
2026-04-04 schematic + routing for imu
    [inspireFly-flightController.kicad_pcb, inspireFly-flightController.kicad_sch]
2026-04-18 fixed up schematic and pcb
    [inspireFly-flightController.kicad_pcb, inspireFly-flightController.kicad_sch]
2026-09-26 added RTC, backup power supply, ideal diode, and switch IC
    [inspireFly-flightController.kicad_sch]
2026-09-28 Magnetorquer Board
    Completed schematic ready for first review
    [Magnetorquer H-Bridge.kicad_pcb, Magnetorquer H-Bridge.kicad_sch]
2026-10-08 Interfaced 1GB flash storage IC onto schematic
2026-10-13 Updated 1GB flash storage IC schematic
2026-10-17 sync PCB with schematic
2026-10-17 added gnd vias for isolated island
2026-10-18 Slight tweaks to 1GB flash storage schematic
2026-10-18 Magnetorquer H-Bridge
    Reuploaded with pins and working libraries (hopefully)
2026-10-23 Interfaced 1GB flash storage IC onto PCB, updated footprints
2026-10-31 fixed imu schematic/routing, and other routing and label issues
2026-11-07 Schematic and routing done for WDT
2026-11-08 Silkscreen update
2026-11-12 4.7K resistor to 0402 fix
2026-11-12 BOM Push
